ztto/USBKBD2X68K/src/keymap.h

// HID Usage ID => X68 スキャンコード 変換テーブル
const uint8_t keytable[] PROGMEM = {
    0x00,    // 00h  []
    0x00,    // 01h  []
    0x00,    // 02h  []
    0x00,    // 03h  []
    0x1e,    // 04h  A
    0x2e,    // 05h  B
    0x2c,    // 06h  C
    0x20,    // 07h  D
    0x13,    // 08h  E
    0x21,    // 09h  F
    0x22,    // 0Ah  G
    0x23,    // 0Bh  H
    0x18,    // 0Ch  I
    0x24,    // 0Dh  J
    0x25,    // 0Eh  K
    0x26,    // 0Fh  L
    0x30,    // 10h  M
    0x2f,    // 11h  N
    0x19,    // 12h  O
    0x1a,    // 13h  P
    0x11,    // 14h  Q
    0x14,    // 15h  R
    0x1f,    // 16h  S
    0x15,    // 17h  T
    0x17,    // 18h  U
    0x2d,    // 19h  V
    0x12,    // 1Ah  W
    0x2b,    // 1Bh  X
    0x16,    // 1Ch  Y
    0x2a,    // 1Dh  Z
    0x02,    // 1Eh  ! 1
    0x03,    // 1Fh  " 2
    0x04,    // 20h  # 3
    0x05,    // 21h  $ 4
    0x06,    // 22h  % 5
    0x07,    // 23h  & 6
    0x08,    // 24h  ' 7
    0x09,    // 25h  ( 8
    0x0a,    // 26h  ) 9
    0x0b,    // 27h  0
    0x1d,    // 28h  Enter
    0x01,    // 29h  Esc
    0x0f,    // 2Ah  Backspace
    0x10,    // 2Bh  Tab
    0x35,    // 2Ch  空白
    0x0c,    // 2Dh  = -
    0x0d,    // 2Eh  ~ ^
    0x1b,    // 2Fh  ` @
    0x1c,    // 30h  { [
    0x00,    // 31h  []
    0x29,    // 32h  } ]
    0x27,    // 33h  + ;
    0x28,    // 34h  * :
    0x60,    // 35h  半角/全角
    0x31,    // 36h  < ,
    0x32,    // 37h  > .
    0x33,    // 38h  ? /
    0x5d,    // 39h  Caps Lock
    0x63,    // 3Ah  F1
    0x64,    // 3Bh  F2
    0x65,    // 3Ch  F3
    0x66,    // 3Dh  F4
    0x67,    // 3Eh  F5
    0x68,    // 3Fh  F6
    0x69,    // 40h  F7
    0x6a,    // 41h  F8
    0x6b,    // 42h  F9
    0x6c,    // 43h  F10
    0x72,    // 44h  F11 ==> OPT.1
    0x73,    // 45h  F12 ==> OPT.2
    0x62,    // 46h  Print Screen ==> COPY
    0x5b,    // 47h  Scroll Lock ==> ローマ字
    0x61,    // 48h  Pause ==> BREAK
    0x5e,    // 49h  INSERT
    0x36,    // 4Ah  HOME
    0x39,    // 4Bh  PAGE UP ==> ROLL DOWN
    0x37,    // 4Ch  DEL
    0x3a,    // 4Dh  End ==> UNDO
    0x38,    // 4Eh  PAGE DOWN ==> ROLL UP
    0x3d,    // 4Fh  RIGHT
    0x3b,    // 50h  LEFT
    0x3e,    // 51h  DOWN
    0x3c,    // 52h  UP
    0x3f,    // 53h  NumLock ==> CLR
    0x52,    // 54h  記号入力     // 0x40 Num /
    0x53,    // 55h  登録        // 0x41 Num *
    0x54,    // 56h  HELP       // 0x42 Num -
    0x5c,    // 57h  コード入力   // 0x46 Num +
    0x4e,    // 58h  Num Enter
    0x4b,    // 59h  Num 1
    0x4c,    // 5Ah  Num 2
    0x4d,    // 5Bh  Num 3
    0x47,    // 5Ch  Num 4
    0x48,    // 5Dh  Num 5
    0x49,    // 5Eh  Num 6
    0x43,    // 5Fh  Num 7
    0x44,    // 60h  Num 8
    0x45,    // 61h  Num 9
    0x4f,    // 62h  Num 0
    0x51,    // 63h  Num .
    0x00,    // 64h  []
    0x00,    // 65h  App
    0x00,    // 66h  []
    0x00,    // 67h  []
    0x00,    // 68h  []
    0x00,    // 69h  []
    0x00,    // 6Ah  []
    0x00,    // 6Bh  []
    0x00,    // 6Ch  []
    0x00,    // 6Dh  []
    0x00,    // 6Eh  []
    0x00,    // 6Fh  []
    0x00,    // 70h  []
    0x00,    // 71h  []
    0x00,    // 72h  []
    0x00,    // 73h  []
    0x00,    // 74h  []
    0x00,    // 75h  []
    0x00,    // 76h  []
    0x00,    // 77h  []
    0x00,    // 78h  []
    0x00,    // 79h  []
    0x00,    // 7Ah  []
    0x00,    // 7Bh  []
    0x00,    // 7Ch  []
    0x00,    // 7Dh  []
    0x00,    // 7Eh  []
    0x00,    // 7Fh  []
    0x00,    // 80h  []
    0x00,    // 81h  []
    0x00,    // 82h  []
    0x00,    // 83h  []
    0x00,    // 84h  []
    0x00,    // 85h  []
    0x00,    // 86h  []
    0x34,    // 87h  _ 
    0x58,    // 88h  カタカナ ひらがな ==> XF4
    0x0e,    // 89h  | 
    0x57,    // 8Ah  変換 ==> XF3
    0x56,    // 8Bh  無変換 ==> XF2
    0x00,    // 8Ch  []
    0x00,    // 8Dh  []
    0x00,    // 8Eh  []
    0x00,    // 8Fh  []
    0x00,    // 90h  []
    0x00,    // 91h  []
    0x00,    // 92h  []
    0x00,    // 93h  []
    0x00,    // 94h  []
    0x00,    // 95h  []
    0x00,    // 96h  []
    0x00,    // 97h  []
    0x00,    // 98h  []
    0x00,    // 99h  []
    0x00,    // 9Ah  []
    0x00,    // 9Bh  []
    0x00,    // 9Ch  []
    0x00,    // 9Dh  []
    0x00,    // 9Eh  []
    0x00,    // 9Fh  []
    0x00,    // A0h  []
    0x00,    // A1h  []
    0x00,    // A2h  []
    0x00,    // A3h  []
    0x00,    // A4h  []
    0x00,    // A5h  []
    0x00,    // A6h  []
    0x00,    // A7h  []
    0x00,    // A8h  []
    0x00,    // A9h  []
    0x00,    // AAh  []
    0x00,    // ABh  []
    0x00,    // ACh  []
    0x00,    // ADh  []
    0x00,    // AEh  []
    0x00,    // AFh  []
    0x00,    // B0h  []
    0x00,    // B1h  []
    0x00,    // B2h  []
    0x00,    // B3h  []
    0x00,    // B4h  []
    0x00,    // B5h  []
    0x00,    // B6h  []
    0x00,    // B7h  []
    0x00,    // B8h  []
    0x00,    // B9h  []
    0x00,    // BAh  []
    0x00,    // BBh  []
    0x00,    // BCh  []
    0x00,    // BDh  []
    0x00,    // BEh  []
    0x00,    // BFh  []
    0x00,    // C0h  []
    0x00,    // C1h  []
    0x00,    // C2h  []
    0x00,    // C3h  []
    0x00,    // C4h  []
    0x00,    // C5h  []
    0x00,    // C6h  []
    0x00,    // C7h  []
    0x00,    // C8h  []
    0x00,    // C9h  []
    0x00,    // CAh  []
    0x00,    // CBh  []
    0x00,    // CCh  []
    0x00,    // CDh  []
    0x00,    // CEh  []
    0x00,    // CFh  []
    0x00,    // D0h  []
    0x00,    // D1h  []
    0x00,    // D2h  []
    0x00,    // D3h  []
    0x00,    // D4h  []
    0x00,    // D5h  []
    0x00,    // D6h  []
    0x00,    // D7h  []
    0x00,    // D8h  []
    0x00,    // D9h  []
    0x00,    // DAh  []
    0x00,    // DBh  []
    0x00,    // DCh  []
    0x00,    // DDh  []
    0x00,    // DEh  []
    0x00,    // DFh  []
    0x71,    // E0h  Left-Ctrl
    0x70,    // E1h  Left-Shift
    0x55,    // E2h  Left-Alt ==> XF1
    0x5f,    // E3h  GUI ==> ひらがな
    0x71,    // E4h  Right-Ctrl
    0x70,    // E5h  Right-Shift
    0x59,    // E6h  Right-Alt ==> XF5
    0x72,    // E7h  Right-GUI ==> OPT.1
};
