ztto/USBKBD2X68K/(commit log)

2021-08-11 keymap追加
2021-08-21 keymap変更
2021-09-26 ドキュメント追加
2021-09-26 ドキュメント修正
2023-03-20 platformIO対応
2023-04-02 コメント追加
